VGCH/NeoPixelClock/img/Снимок экрана 2024-11-07 в 13.38.01.png

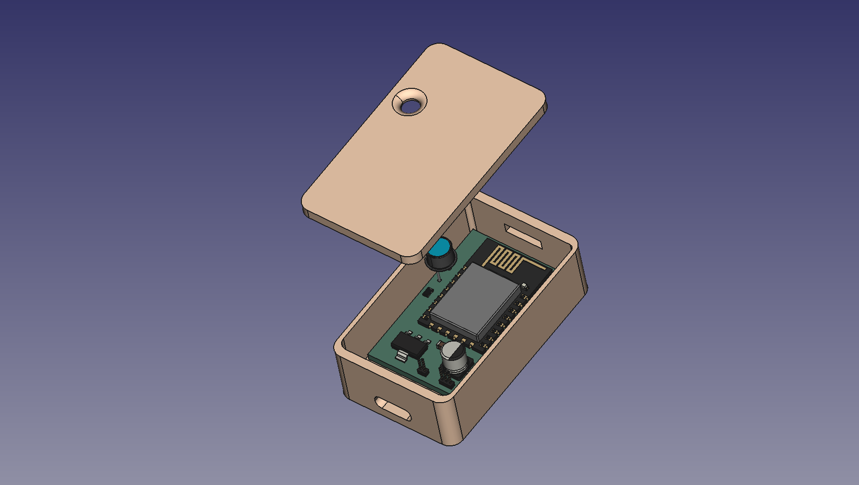
img/Снимок экрана 2024-11-07 в 13.38.01.png
