VGCH/NeoPixelClock/img/NeoPixel_c.png

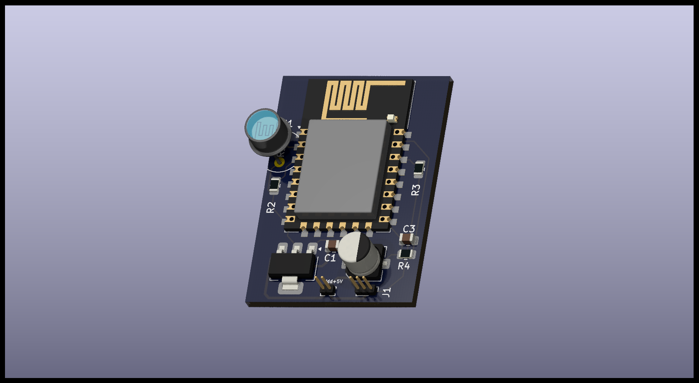
img/NeoPixel_c.png
