VGCH/NeoPixelClock/img/circut.png

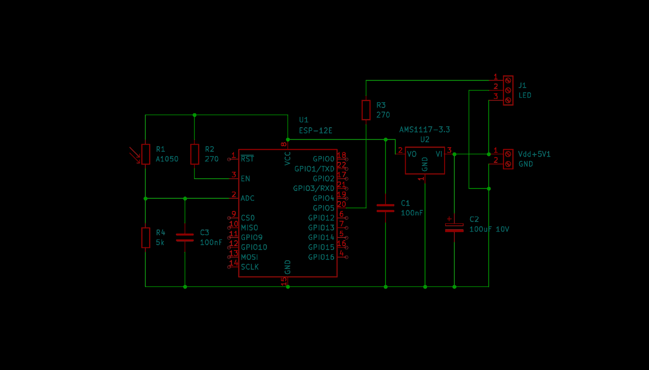
img/circut.png
