VGCH/NeoPixelClock/img/collect.jpg

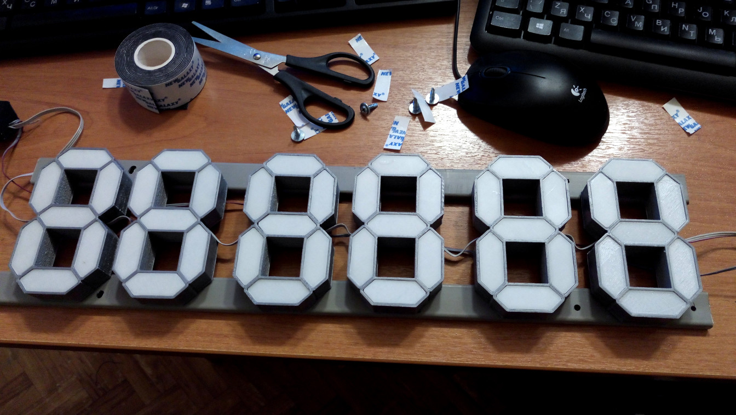
img/collect.jpg
