VGCH/NeoPixelClock/img/kstatie.jpg

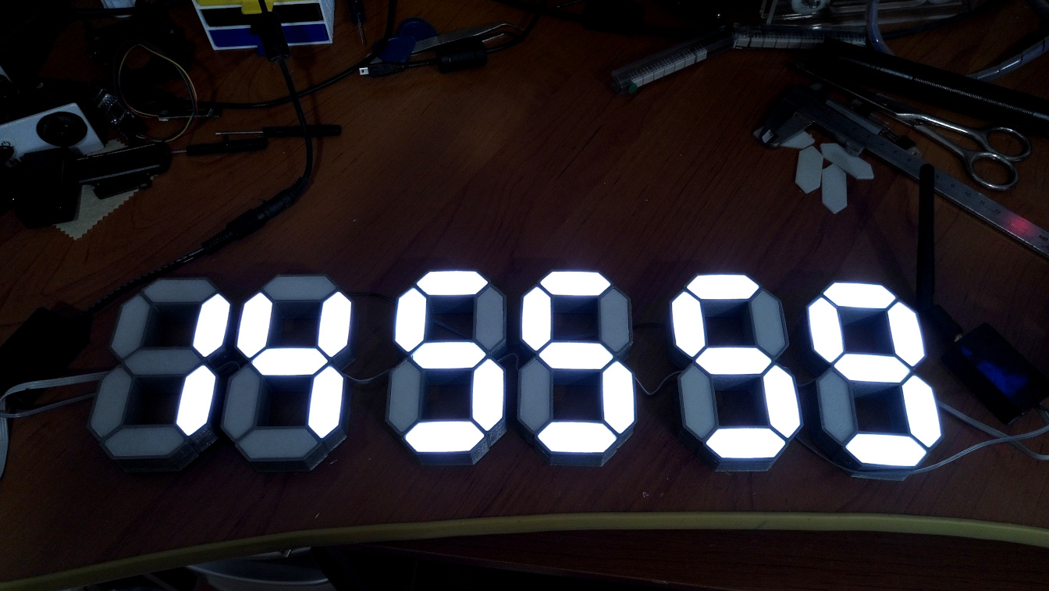
img/kstatie.jpg
