VGCH/NeoPixelClock/img/newseg.jpg

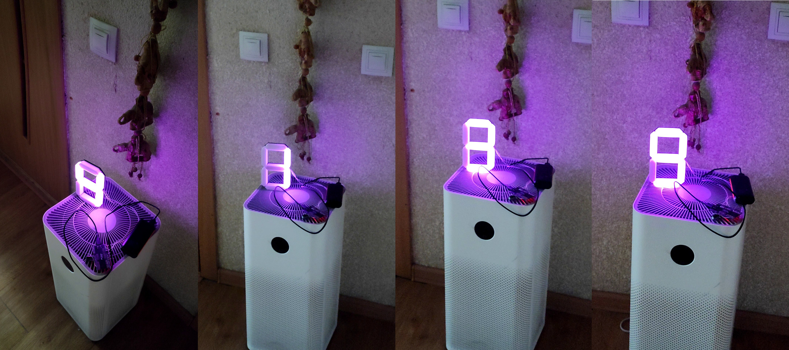
img/newseg.jpg
