VGCH/NeoPixelClock/img/pixelchain.png

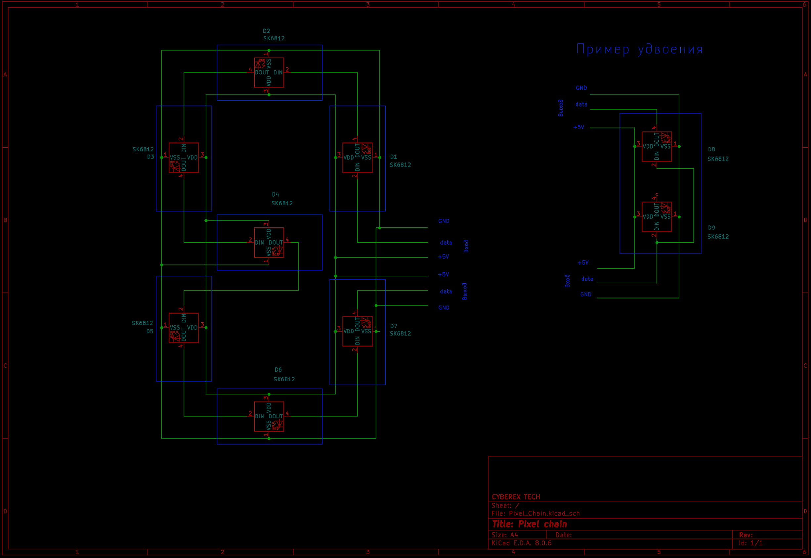
img/pixelchain.png
