VGCH/NeoPixelClock/board/NeoPixel_c/NeoPixel_c.step

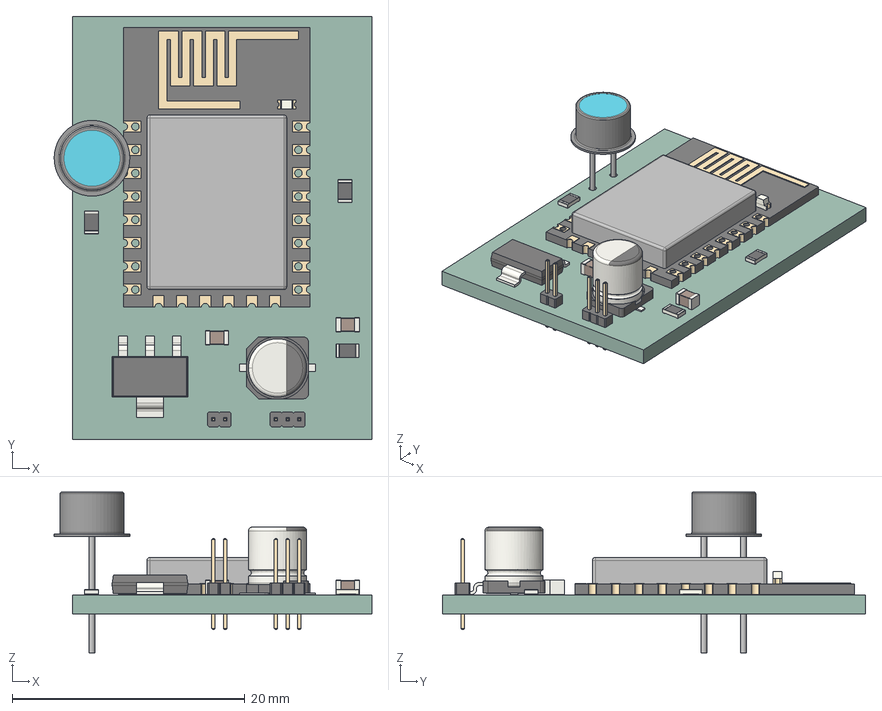
[picture p8: CAD file, 2024-11-08]
board/NeoPixel_c/NeoPixel_c.step
27.3 x 36.3 x 13.8 mm
SOT_223
CP_Elec_5x58
R_0805_2012Metric x 3
PinHeader_1x03_P100mm_Vertical
PinHeader_1x02_P100mm_Vertical
ESP_12E001_cp
R_LDR_D6.4mm_P3.4mm_Vertical
C_0805_2012Metric x 2
NeoPixel_c_PCB
