VGCH/NeoPixelClock/STL/ControllerBox/box.stl

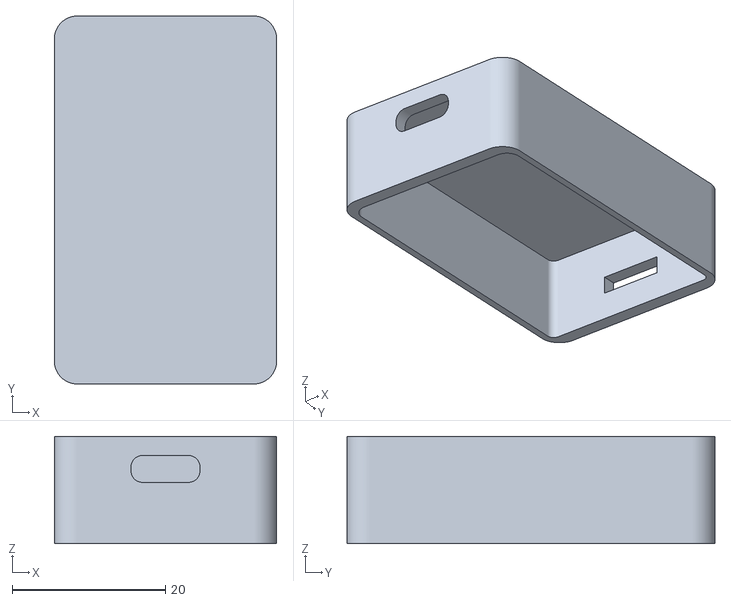
[picture p9: CAD file, 2024-11-08]
STL/ControllerBox/box.stl
29.0 x 48.0 x 14.0
