VGCH/NeoPixelClock/STL/NewDigitModule/bottom.stl

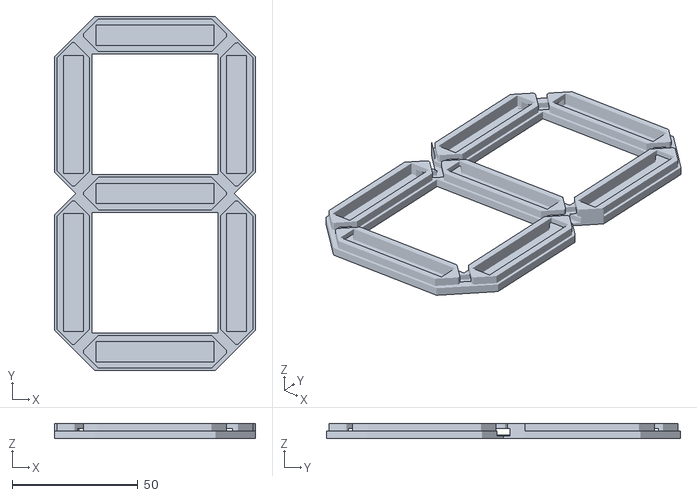
[picture p10: CAD file, 2024-11-08]
STL/NewDigitModule/bottom.stl
80.0 x 141.0 x 6.00
