VGCH/NeoPixelClock/STL/ControllerBox/cap.stl

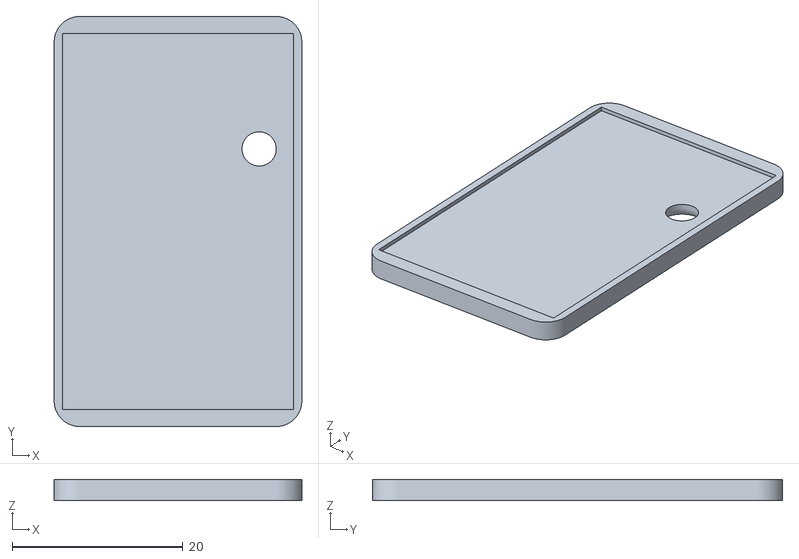
[picture p11: CAD file, 2024-11-08]
STL/ControllerBox/cap.stl
29.0 x 48.0 x 2.50
