VGCH/NeoPixelClock/STL/NewDigitModule/segment.stl

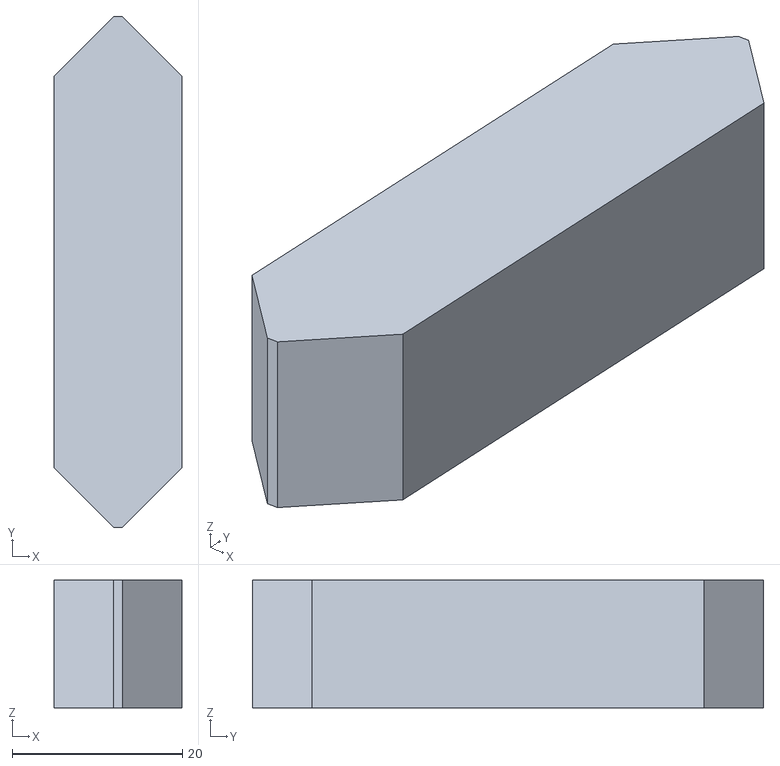
[picture p12: CAD file, 2024-11-08]
STL/NewDigitModule/segment.stl
15.0 x 60.0 x 15.0
