VGCH/NeoPixelClock/STL/OldDigitModule/box.stl

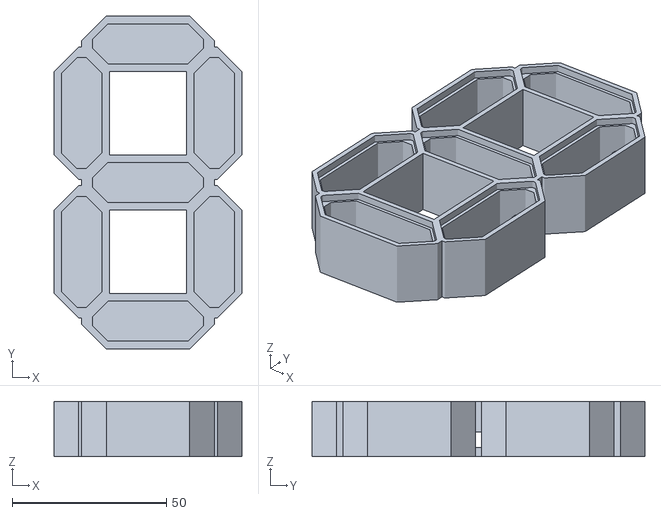
[picture p13: CAD file, 2024-11-08, an earlier design]
STL/OldDigitModule/box.stl
61.0 x 108.0 x 18.0
