VGCH/NeoPixelClock/STL/OldDigitModule/segment.stl

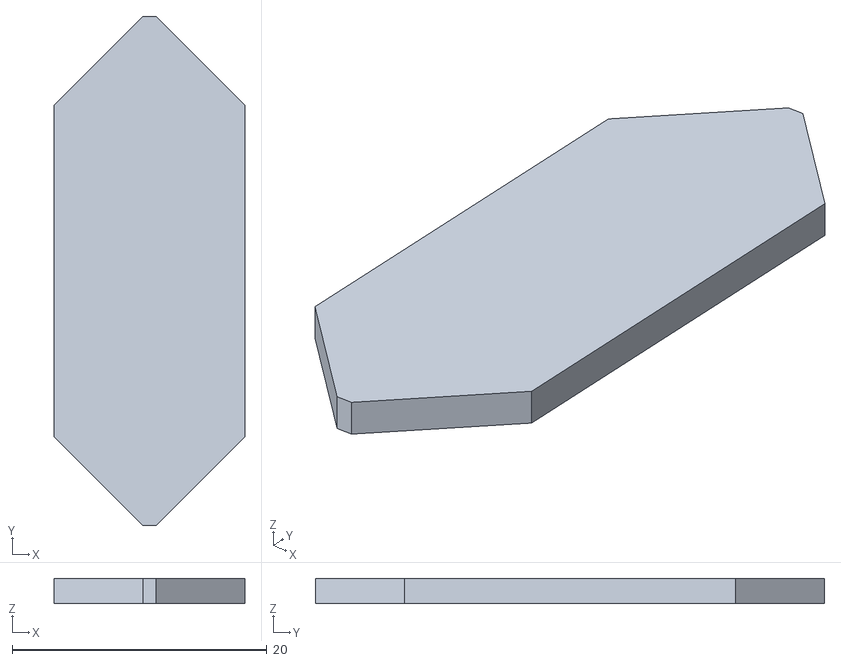
[picture p14: CAD file, 2024-11-08, an earlier design]
STL/OldDigitModule/segment.stl
15.0 x 40.0 x 2.00
