VGCH/NeoPixelClock/board/Pixel_Chain/circut.pdf

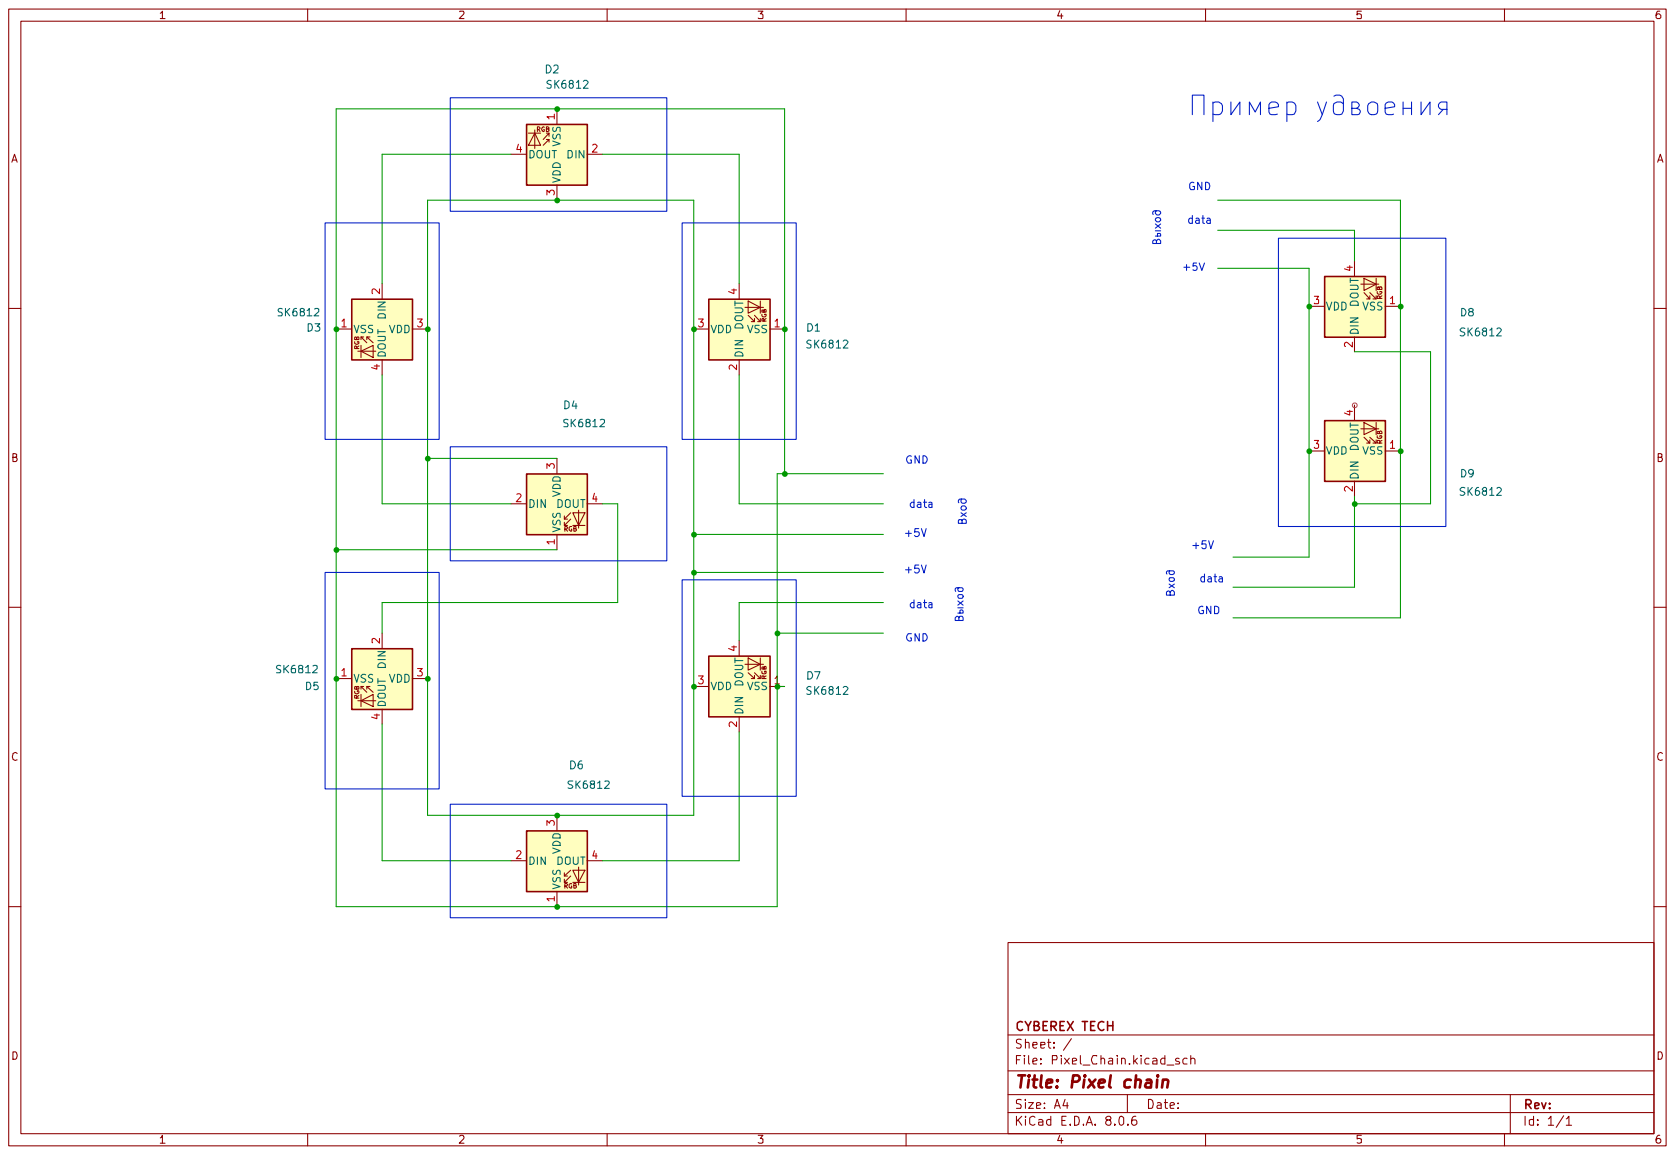
[picture p15: page 1]
