VGCH/NeoPixelClock/board/NeoPixel_c/NeoPixel_c.kicad_pcb

## KiCad design board/NeoPixel_c/NeoPixel_c.kicad_pcb (2024-11-08)

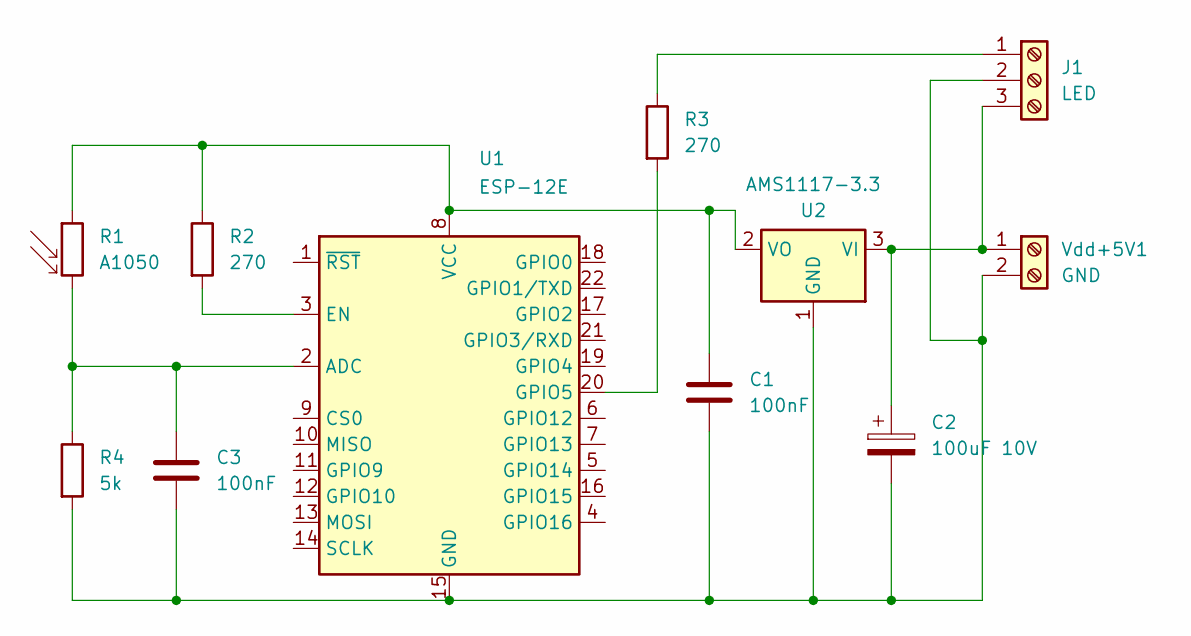
[picture p16: schematic NeoPixel_c.kicad_sch, Neo Pixel Clock Driver]

Parts:
C1, C3: 100nF; C_0805_2012Metric
C2: 100uF 10V; CP_Elec_5x5.8
J1: LED; PinHeader_1x03_P1.00mm_Vertical
R1: A1050; R_LDR_D6.4mm_P3.4mm_Vertical
R2, R3: 270; R_0805_2012Metric
R4: 5k; R_0805_2012Metric
U1: ESP-12E
U2: AMS1117-3.3; SOT-223-3_TabPin2
Vdd+5V1: GND; PinHeader_1x02_P1.00mm_Vertical

Connections:
unnamed: J1.1, R3.1
unnamed 1: C1.2, C2.2, C3.2, J1.2, R4.2, U1.15 (GND), U2.1 (GND), Vdd+5V1.2; also elsewhere on the board
unnamed 2: C2.1, J1.3, U2.3 (VI), Vdd+5V1.1; also elsewhere on the board
unnamed: C3.1, R1.2, R4.1, U1.2 (ADC)
unnamed: R2.2, U1.3 (EN)
unnamed: R3.2, U1.20 (GPIO5)
unnamed: C1.1, R1.1, R2.1, U1.8 (VCC), U2.2 (VO)

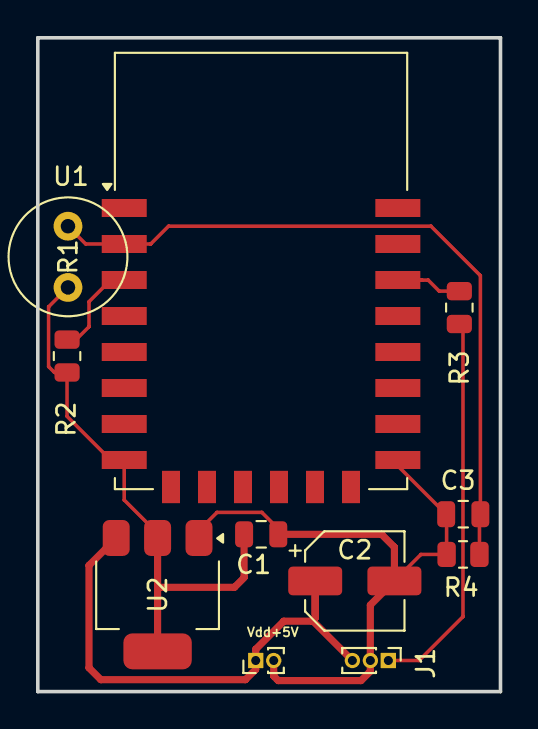
[picture p17: board NeoPixel_c.kicad_pcb from above]

Board: 2 copper layers, 25.7 x 36.3 mm, 11 parts (0 on the bottom side), 7 nets.

Other parts of the board:
Vdd+5V: GND; PinHeader_1x02_P1.00mm_Vertical

Their connections:
unnamed 1: Vdd+5V.2; also elsewhere on the board
unnamed 2: Vdd+5V.1; also elsewhere on the board
