VGCH/NeoPixelClock/NeoClockPixel/digits_p.h

const int digits_pix[20][7] PROGMEM = {
    {1, 1, 1, 0, 1, 1, 1},                  // 0
    {1, 0, 0, 0, 0, 0, 1},                  // 1
    {1, 1, 0, 1, 1, 1, 0},                  // 2
    {1, 1, 0, 1, 0, 1, 1},                  // 3
    {1, 0, 1, 1, 0, 0, 1},                  // 4
    {0, 1, 1, 1, 0, 1, 1},                  // 5
    {0, 1, 1, 1, 1, 1, 1},                  // 6
    {1, 1, 0, 0, 0, 0, 1},                  // 7
    {1, 1, 1, 1, 1, 1, 1},                  // 8
    {1, 1, 1, 1, 0, 1, 1},                  // 9
    {0, 0, 0, 0, 0, 0, 0},                  // Очистка            10
    {0, 0, 1, 1, 1, 1, 0},                  // Температура t      11
    {1, 0, 1, 1, 1, 0, 1},                  // Влажность H        12
    {1, 1, 1, 1, 1, 0, 0},                  // Давление P         13
    {1, 1, 1, 1, 0, 0, 0},                  // Градус Цельсия С   14
    {0, 1, 1, 0, 1, 1, 0},                  // Градус Цельсия С * 15
    {0, 0, 0, 1, 0, 0, 0},                  // Знак минуса        16
    {0, 1, 1, 1, 1, 1, 0},                  // E                  17
    {0, 1, 1, 0, 1, 0, 0},                  // L                  18
    {1, 1, 1, 0, 1, 1, 1}                   // O                  19
};
